Aparajith-S/German_word_clock/doc/assy.jpg

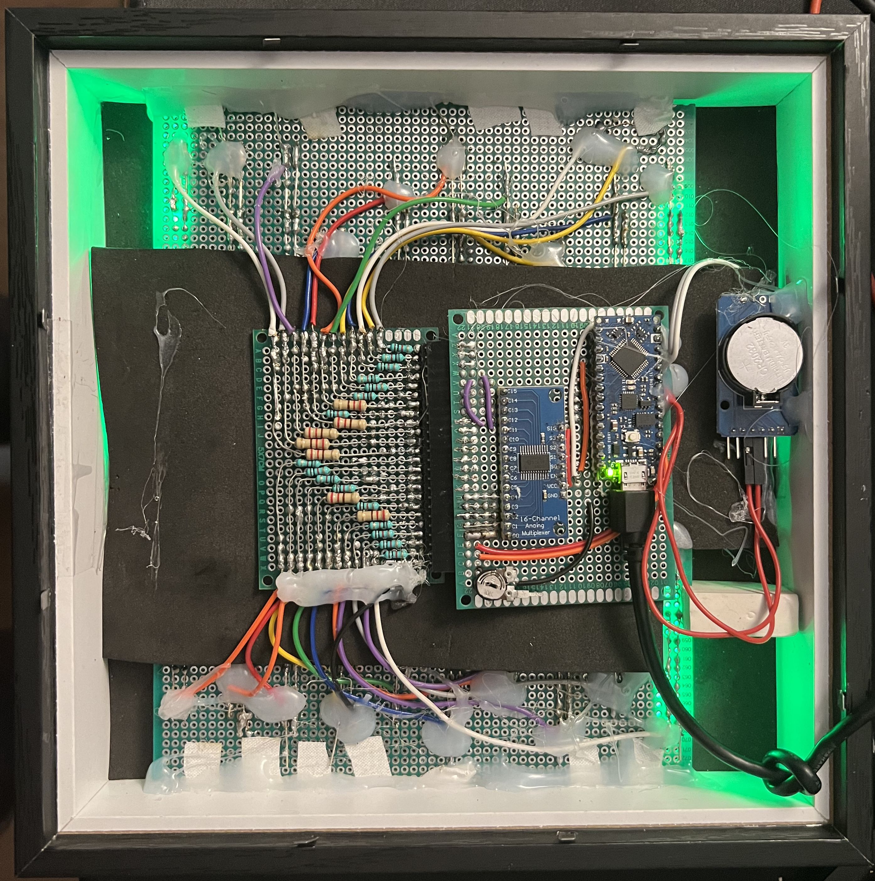
doc/assy.jpg
