Aparajith-S/German_word_clock/doc/Picture3.png

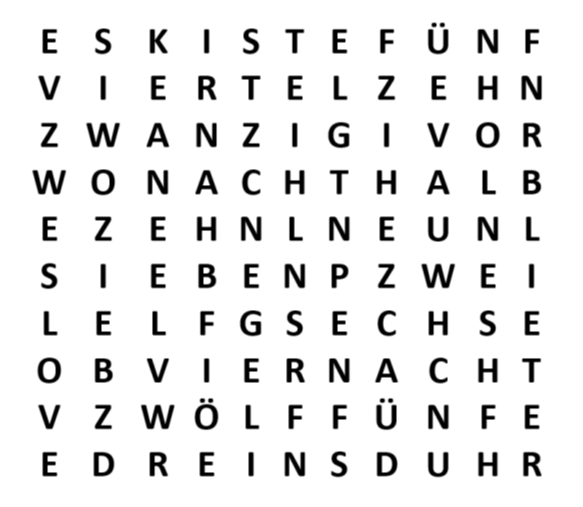
doc/Picture3.png
